jinglebells2020/netrodrone/cad/out/step/netrodrone_assembly.step

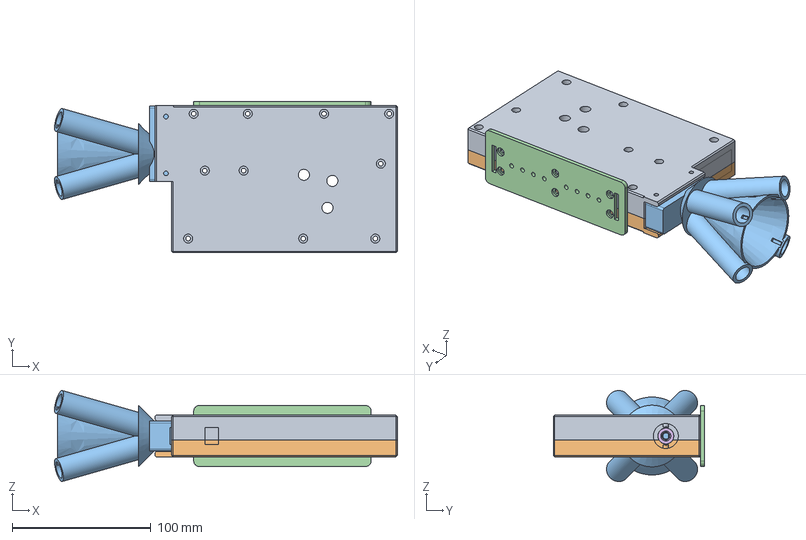
[picture p15: CAD file, 2026-10-27]
cad/out/step/netrodrone_assembly.step
247.4 x 109.2 x 65.7 mm
