jinglebells2020/netrodrone/cad/out/step/nozzle_seal_sleeve_S8.step

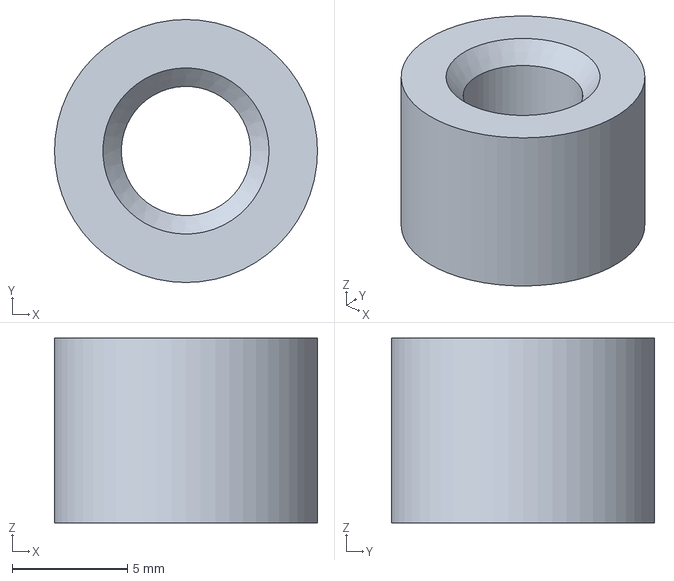
[picture p16: CAD file, 2026-10-27]
cad/out/step/nozzle_seal_sleeve_S8.step
11.4 x 11.4 x 8.00 mm
