jinglebells2020/netrodrone/cad/out/stl/net_weight_x4.stl

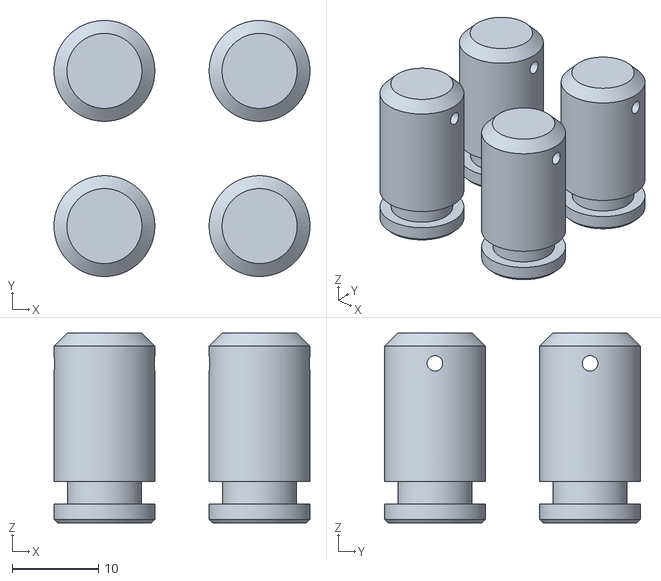
[picture p17: CAD file, 2026-10-27]
cad/out/stl/net_weight_x4.stl
29.7 x 29.7 x 22.0
