jinglebells2020/netrodrone/cad/source/gearbox_v2_original.step

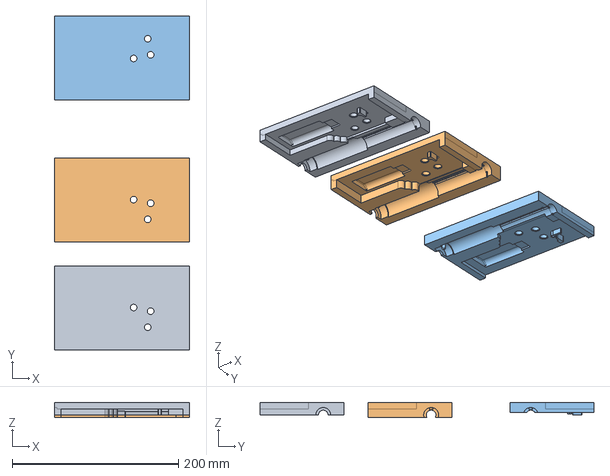
[picture p18: CAD file, 2026-10-27]
cad/source/gearbox_v2_original.step
163.0 x 402.4 x 18.0 mm
