jinglebells2020/netrodrone/cad/out/step/nozzle_seal_sleeve_S11.step

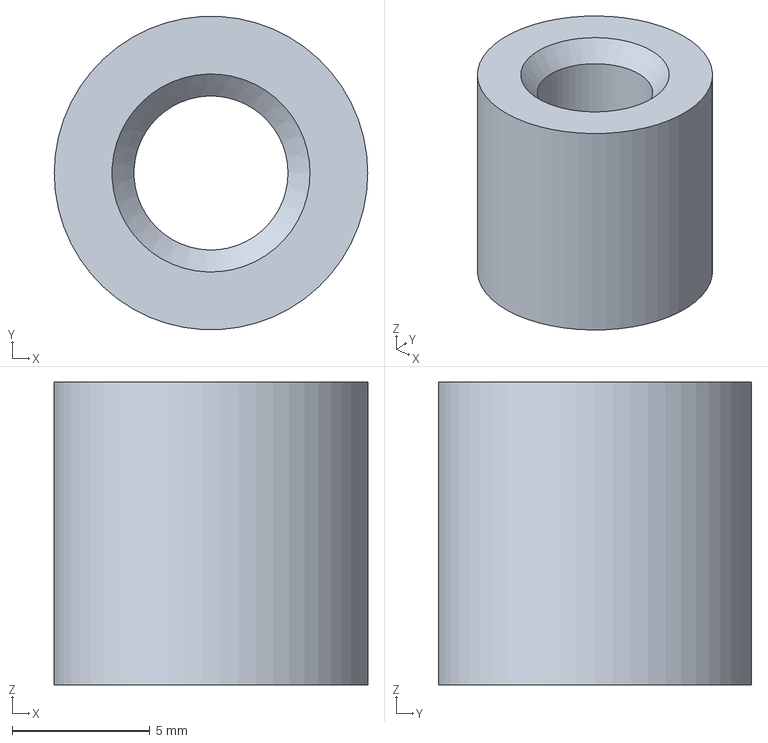
[picture p19: CAD file, 2026-10-27]
cad/out/step/nozzle_seal_sleeve_S11.step
11.4 x 11.4 x 11.0 mm
