jinglebells2020/netrodrone/cad/out/stl/nozzle_seal_sleeve_S14_TPU.stl

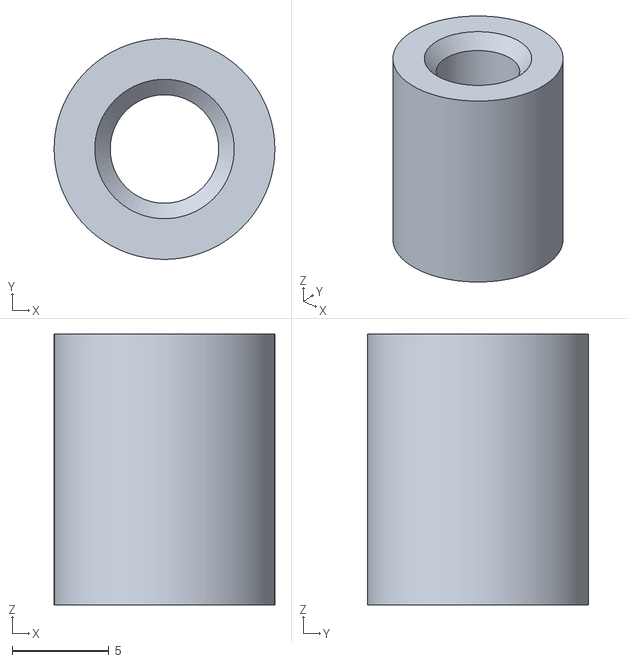
[picture p20: CAD file, 2026-10-27]
cad/out/stl/nozzle_seal_sleeve_S14_TPU.stl
11.4 x 11.4 x 14.0
