jinglebells2020/netrodrone/cad/out/step/nozzle_seal_sleeve_S17.step

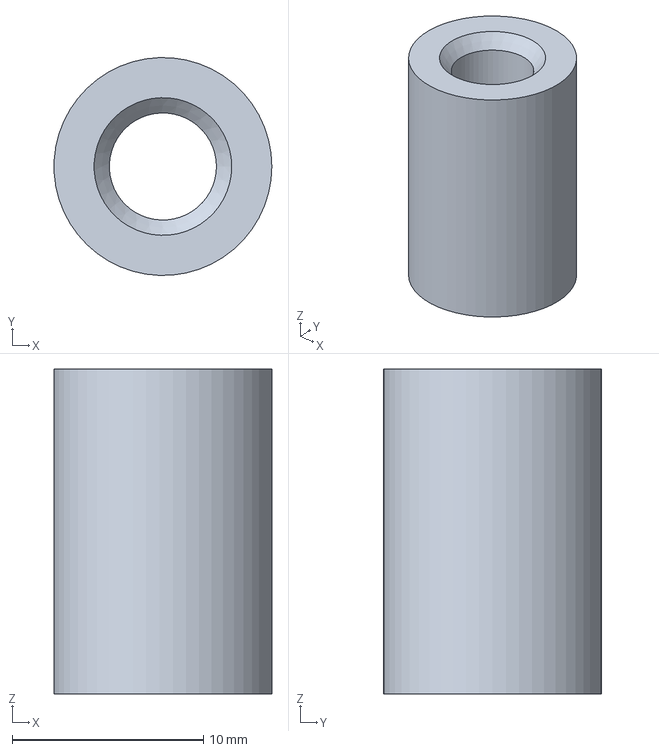
[picture p21: CAD file, 2026-10-27]
cad/out/step/nozzle_seal_sleeve_S17.step
11.4 x 11.4 x 17.0 mm
