jinglebells2020/netrodrone/cad/out/stl/nozzle_seal_sleeve_S5_TPU.stl

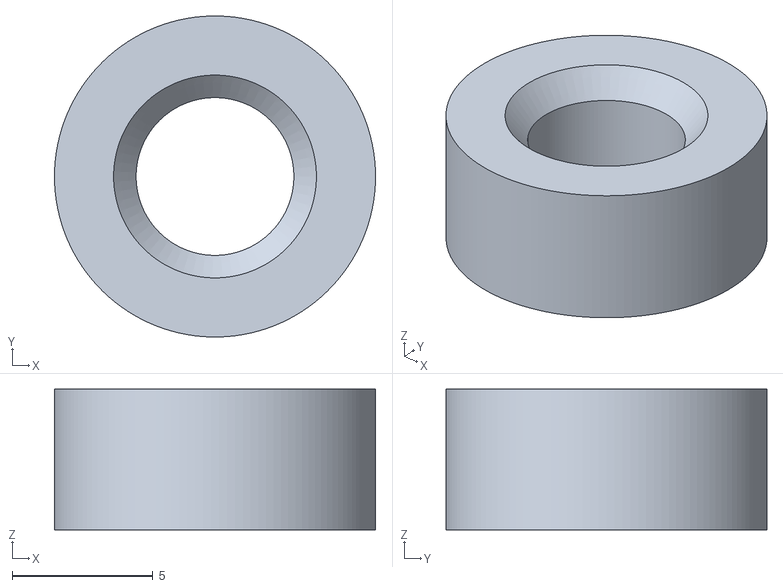
[picture p22: CAD file, 2026-10-27]
cad/out/stl/nozzle_seal_sleeve_S5_TPU.stl
11.4 x 11.4 x 5.00
