jinglebells2020/netrodrone/cad/out/step/gearbox_half_B.step

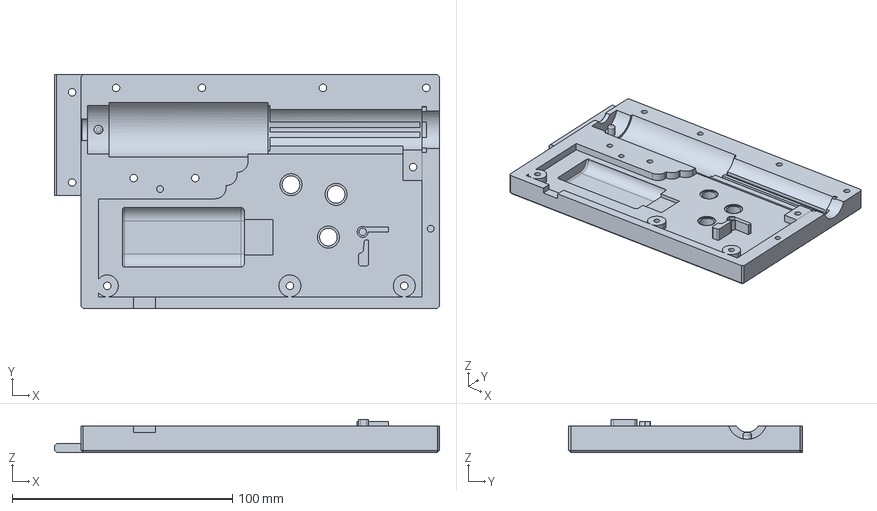
[picture p23: CAD file, 2026-10-27]
cad/out/step/gearbox_half_B.step
175.0 x 106.2 x 15.0 mm
