jinglebells2020/netrodrone/cad/out/step/mount_plate.step

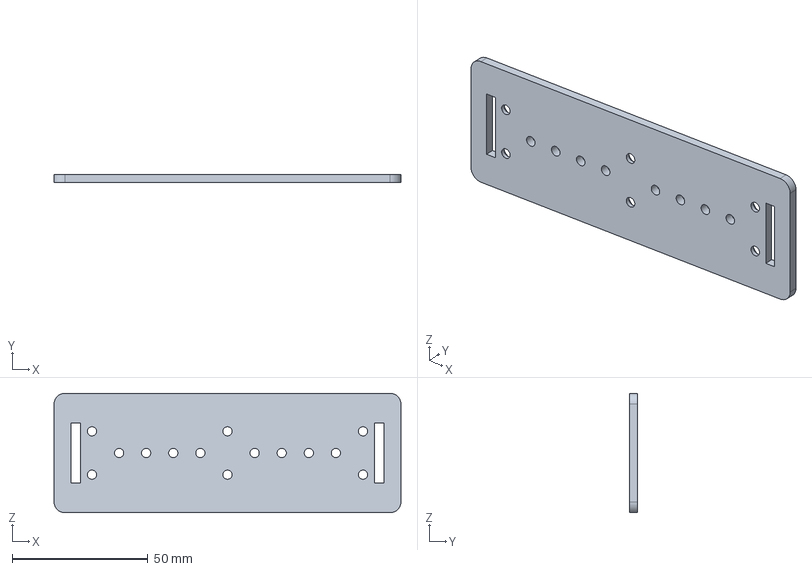
[picture p24: CAD file, 2026-10-27]
cad/out/step/mount_plate.step
128.0 x 3.00 x 44.0 mm
