jinglebells2020/netrodrone/cad/out/step/net_weight.step

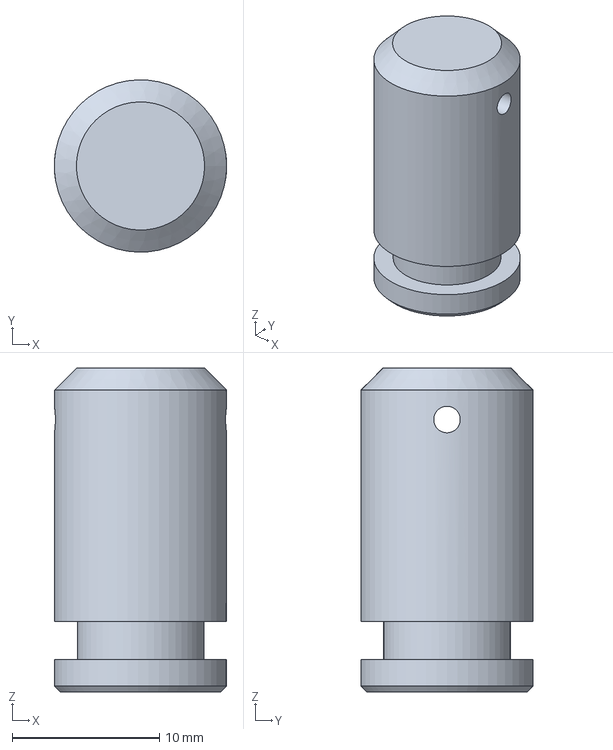
[picture p25: CAD file, 2026-10-27]
cad/out/step/net_weight.step
11.7 x 11.7 x 22.0 mm
