jinglebells2020/netrodrone/cad/out/step/gearbox_half_A.step

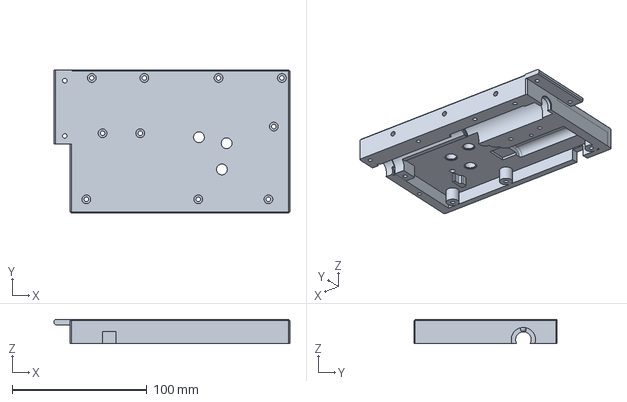
[picture p26: CAD file, 2026-10-27]
cad/out/step/gearbox_half_A.step
175.0 x 106.2 x 18.0 mm
