jinglebells2020/netrodrone/cad/out/step/launcher_head.step

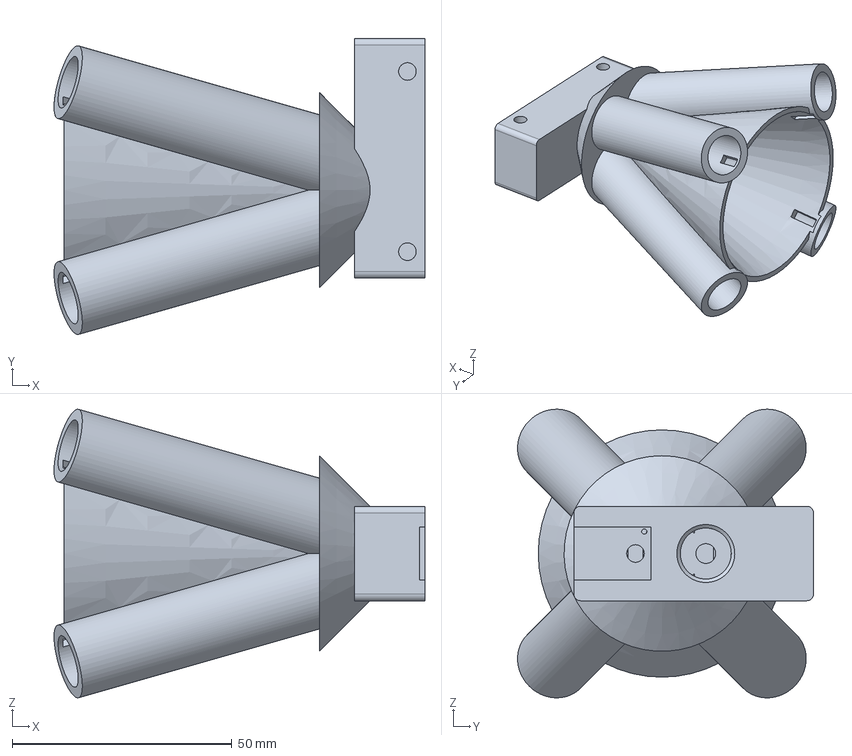
[picture p27: CAD file, 2026-10-27]
cad/out/step/launcher_head.step
84.4 x 67.3 x 65.7 mm
