jinglebells2020/netrodrone/(list of files, cad)

Other CAD files:
cad/out/stl/nozzle_seal_sleeve_S11_TPU.stl
cad/out/stl/nozzle_seal_sleeve_S17_TPU.stl
cad/out/step/nozzle_seal_sleeve_S14.step
cad/out/stl/nozzle_seal_sleeve_S8_TPU.stl
cad/out/step/nozzle_seal_sleeve_S5.step
cad/out/stl/gearbox_half_A.stl
cad/out/stl/gearbox_half_B.stl
cad/out/stl/launcher_head.stl
cad/out/stl/mount_plate.stl
