jinglebells2020/netrodrone/analysis/RESULTS.md

# Simulation results

Generated by `analysis/run_analysis.py`. Design point: 4 barrels, bore 12 mm, 42 mm weight travel, stock AEG nozzle (4 mm bore), O-ring sealed weights, 22° spread, 1.2 m net.

## Spring calibration (from the AEG rating: M120 = ~120 m/s with a 0.20 g BB)

| spring | model | rate k (N/mm) | force cocked (N) | stored energy (J) |
|---|---|---|---|---|
| M100 | conservative | 0.43 | 46 | 1.79 |
| M100 | expected | 0.67 | 71 | 2.81 |
| M120 | conservative | 0.55 | 59 | 2.31 |
| M120 | expected | 0.82 | 88 | 3.45 |
| M150 | conservative | 0.77 | 82 | 3.24 |
| M150 | expected | 1.10 | 118 | 4.63 |

## Weight speed leaving the barrels (m/s), conservative - expected

| spring | 6 g | 8 g (design) | 10 g | 12 g | energy to weights @ 8 g (J) | peak pressure @ 8 g (bar) |
|---|---|---|---|---|---|---|
| M100 | 8.5 - 9.6 | 7.5 - 8.5 | 6.7 - 7.6 | 6.0 - 6.8 | 0.90 - 1.15 | 1.7 - 2.1 |
| M120 | 10.5 - 11.3 | 9.3 - 10.0 | 8.3 - 8.9 | 7.5 - 8.1 | 1.38 - 1.60 | 2.4 - 2.9 |
| M150 | 13.1 - 13.4 | 11.6 - 11.9 | 10.5 - 10.8 | 9.4 - 9.9 | 2.17 - 2.28 | 4.2 - 4.8 |

Shot duration (release to weights out): 10.9 ms (M120). Piston hits the cylinder head at <= 2.9 m/s (the air in front of it cushions the stop).

## Net flight (1.2 m net, 4 x 8 g, 22°)

| spring | model | weight speed (m/s) | 70 % open at | 90 % open at | capture window |
|---|---|---|---|---|---|
| M100 | conservative | 7.5 | 1.6 m | 2.2 m | 1.6 - 3.1 m |
| M100 | expected | 8.5 | 1.5 m | 2.1 m | 1.5 - 3.4 m |
| M120 | conservative | 9.3 | 1.5 m | 2.1 m | 1.5 - 3.6 m |
| M120 | expected | 10.0 | 1.5 m | 2.1 m | 1.5 - 3.8 m |
| M150 | conservative | 11.6 | 1.6 m | 2.1 m | 1.6 - 4.2 m |
| M150 | expected | 11.9 | 1.5 m | 2.1 m | 1.5 - 4.2 m |

## What breaks it, what doesn't (M120, 8 g weights)

| change from the design | weight speed (m/s) | change |
|---|---|---|
| design point (check valve + 1 mm bleed, O-rings, 4 mm nozzle) | 9.3 | +0 % |
| **no check valve** (system sealed between shots) | 0.0 | **weights do not leave the barrels** |
| no check valve, but a vented AEG piston head (~2 mm2) | 7.0 | -24 % |
| **no O-rings on the weights** (0.1 mm printed gap) | 0.0 | **weights do not leave the barrels** |
| worn / dry O-rings (1 mm2 leak each) | 7.7 | -18 % |
| high O-ring friction (3 N each) | 8.2 | -12 % |
| nozzle bore 3.5 mm | 8.7 | -6 % |
| nozzle bore 5.0 mm | 9.8 | +5 % |
| bleed hole 1.5 mm | 8.8 | -5 % |
| no bleed hole | 9.6 | +4 % |
| fast cocking (15 ms) | 9.5 | +2 % |
| slow cocking (40 ms) | 9.2 | -1 % |
| weight travel 36 mm | 9.4 | +1 % |
| weight travel 48 mm | 9.1 | -2 % |
| 4 x 14 mm bores, 100 mm travel (barrels too big) | 0.0 | **weights do not leave the barrels** |

## Spread angle (M120, conservative)

| half-angle | 90 % open at | capture window |
|---|---|---|
| 18° | 3.0 m | 2.0 - 4.0 m |
| 22° | 2.1 m | 1.5 - 3.6 m |
| 26° | 1.7 m | 1.2 - 3.2 m |
| 30° | 1.4 m | 0.9 - 2.9 m |
