jinglebells2020/netrodrone/analysis/turret/RESULTS.md

# Turret engagement simulation

Generated by `engage.py`. A drone dives 20° at a point on the building at 30 m/s (108 km/h) unless stated; it is first seen 60 m out, from a random direction, so the head may have to turn up to 180°. Each cell is the share of 1000 engagements that end in a catch. Light launcher (2 m net, 36 J) unless stated.

Baseline: camera + 0.5 m ranging, 30 measurements a second with 80 ms delay, head turning 180°/s, 40 ms from fire command to the net leaving, net thrown within 1.5° and 4 % of its nominal speed.

## How far from the turret can the drone be aimed?

| sensor | 0 m | 1 m | 2 m | 3 m | 4 m | 5 m |
|---|---|---|---|---|---|---|
| camera only (range guessed from image size) | 100 % | 98 % | 91 % | 74 % | 53 % | 30 % |
| camera + rangefinder or small radar (0.5 m) | 100 % | 99 % | 94 % | 88 % | 93 % | 88 % |
| camera + good radar (0.15 m) | 100 % | 100 % | 94 % | 96 % | 95 % | 94 % |

Column = how far the drone's aim point is from the turret. Beyond the net's reach nothing helps.

## Drone speed (aim point 1 m from the turret)

| sensor | 20 m/s | 30 m/s | 40 m/s |
|---|---|---|---|
| camera only (range guessed from image size) | 100 % | 97 % | 75 % |
| camera + rangefinder or small radar (0.5 m) | 100 % | 99 % | 84 % |
| camera + good radar (0.15 m) | 100 % | 100 % | 87 % |

## Head speed and how early the drone is seen (aim point 1 m away)

| head turns at | seen at 40 m | seen at 60 m | seen at 80 m |
|---|---|---|---|
| 60°/s | 26 % | 44 % | 63 % |
| 120°/s | 51 % | 88 % | 99 % |
| 180°/s | 71 % | 99 % | 100 % |
| 360°/s | 97 % | 100 % | 100 % |

## Measurement rate and delay

| sensor timing | aim point 1 m away | 3 m away |
|---|---|---|
| 15 pictures a second, 150 ms delay | 96 % | 83 % |
| 30 a second, 80 ms | 99 % | 89 % |
| 60 a second, 30 ms | 99 % | 84 % |

## A drone that does not fly straight (aim point 1 m away)

The drone weaves from side to side once a second; the column is the peak sideways acceleration. 'Far' and 'near' are where the fire control prefers to meet the drone within the net's reach.

| launcher, meeting point | straight | 0.25 g | 0.5 g | 1 g | 2 g |
|---|---|---|---|---|---|
| light, far (about 6 m out) | 99 % | 98 % | 95 % | 52 % | 0 % |
| light, near (about 2 m out) | 69 % | 60 % | 44 % | 10 % | 1 % |
| medium, far (about 8 m out) | 99 % | 100 % | 99 % | 90 % | 4 % |
| medium, near (about 3 m out) | 86 % | 79 % | 64 % | 21 % | 5 % |
| medium-wide, far (about 6 m out) | 99 % | 99 % | 98 % | 86 % | 7 % |
| medium-wide, near (about 2 m out) | 74 % | 67 % | 52 % | 35 % | 5 % |
| heavy, far (about 14 m out) | 100 % | 100 % | 99 % | 96 % | 38 % |
| heavy, near (about 6 m out) | 100 % | 100 % | 97 % | 70 % | 5 % |
| heavy-wide, far (about 9 m out) | 100 % | 100 % | 99 % | 99 % | 80 % |
| heavy-wide, near (about 3 m out) | 88 % | 83 % | 70 % | 44 % | 11 % |

## How far from the turret can the drone be aimed, by launcher

| light: aim point from the turret | 0 m | 1 m | 2 m | 3 m | 4 m | 5 m | 6 m |
|---|---|---|---|---|---|---|---|
| catch | 100 % | 99 % | 95 % | 86 % | 92 % | 86 % | 1 % |

| medium: aim point from the turret | 0 m | 2 m | 4 m | 6 m | 8 m | 10 m |
|---|---|---|---|---|---|---|
| catch | 100 % | 98 % | 97 % | 98 % | 55 % | 0 % |

| medium-wide: aim point from the turret | 0 m | 2 m | 4 m | 6 m | 8 m |
|---|---|---|---|---|---|
| catch | 100 % | 97 % | 82 % | 68 % | 0 % |

| heavy: aim point from the turret | 0 m | 4 m | 8 m | 12 m | 16 m |
|---|---|---|---|---|---|
| catch | 100 % | 96 % | 90 % | 72 % | 0 % |

| heavy-wide: aim point from the turret | 0 m | 2 m | 4 m | 6 m | 8 m | 10 m |
|---|---|---|---|---|---|---|
| catch | 100 % | 99 % | 99 % | 91 % | 95 % | 0 % |

## What else could go wrong (aim point 1 m away)

| change | catch | typical sideways miss |
|---|---|---|
| baseline | 100 % | 0.21 m |
| net thrown 4 deg off instead of 1.5 | 88 % | 0.47 m |
| net speed varies 10 % instead of 4 % | 99 % | 0.21 m |
| valve takes 100 ms instead of 40 ms (known) | 99 % | 0.23 m |

## Tracking head v0: two fixed cameras as a stereo pair, hobby bus servos

Two identical cameras 0.4 m apart at 1280 x 720 give range from the difference between the two pictures; the error grows with distance squared (about 2.3 m at 60 m, 0.6 m at 30 m, 0.14 m at 15 m). Drone seen at 45 m, head turning 250°/s, 30 measurements a second with 50 ms delay, light launcher.

| aim point from the turret | 0 m | 1 m | 2 m | 3 m | 4 m | 5 m |
|---|---|---|---|---|---|---|
| catch (30 m/s, straight) | 100 % | 98 % | 96 % | 97 % | 95 % | 85 % |

| aim point 1 m away | 20 m/s | 30 m/s | 40 m/s | weaving 0.5 g | 1 g |
|---|---|---|---|---|---|
| catch | 100 % | 99 % | 78 % | 95 % | 51 % |

## Why engagements fail (baseline sensor)

| aim point from the turret | caught | fired and missed | head not ready | never in reach |
|---|---|---|---|---|
| 0 m | 100 % | 0 % | 0 % | 0 % |
| 1 m | 99 % | 0 % | 0 % | 0 % |
| 2 m | 94 % | 3 % | 0 % | 3 % |
| 3 m | 88 % | 11 % | 0 % | 1 % |
| 4 m | 93 % | 7 % | 0 % | 0 % |
| 5 m | 88 % | 12 % | 0 % | 0 % |

Not modelled: evasion other than a steady weave, several drones at once, rain or darkness on the camera, and what the netted drone does afterwards (it keeps most of its speed; see the discussion of catch distance).
