jinglebells2020/netrodrone/(commit log)

2026-10-27 Add V2-gearbox net launcher: improved gearbox halves, launcher head, physics checks
    Gearbox (built from the user's "GearBox V2 lower" STEP, bodies BLOCK (1) and
    BLOCK (1) (1)): every component fit is kept; changes are boolean adds/cuts only.
    - close the open gear-pocket bottom (5 mm wall + motor-wire slot)
    - 10 x M3 through-bolts (counterbores / nut traps), 3 pocket bosses, 2 dowels
    - forward tabs that hold the launcher head, 6 M3 insert holes for a drone mount
    - 1 mm outer chamfers
    Net launcher (new parts): 4-barrel head (12 mm bores, 22 deg spread, net cup),
    BB check valve + bleed so the sealed launcher refills while cocking, O-ring
    sealed 8 g net weights, TPU nozzle seal sleeves (5 lengt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
    [gearbox_half_A.step, gearbox_half_A.stl, gearbox_half_B.step, gearbox_half_B.stl, gearbox_v2_original.step, launcher_head.step, launcher_head.stl, mount_plate.step]
2026-10-27 Add tactics studies, method comparison and research notes
    - analysis/tactics/: firing modes vs airspeed, down-strike drift, the drape
    tactic (original and fixed), 150 km/h targets, and a fast numba capture
    model (capture.py, validated against drape.py and netflight.py) used to
    compare every method head-to-head over target speed and aiming error
    (6,704 runs in out/compare_methods.csv, tables in RESULTS.md)
    - docs/RESEARCH.md: findings with sources (what pushes what, detection and
    the from-above tactic, latex bands, drape, fast targets, attack-drone
    speeds, market size)
    - docs/figures/: scripts and three.js renderer for the CAD pictures
    - docs/images/: what_flies_out, drape_tactic,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
    [compare_methods.csv]
2026-11-10 Add roof-turret study: launcher sizing, fire control and engagement simulation
    Start of the roof turret: a fixed net launcher on a building that tracks an
    incoming drone and throws a net into its path.
    - analysis/turret/classes.py: launcher sizes compared (2 m to 5 m nets, 36-720 J)
    - analysis/turret/envelope.py: net flight tables from the capture model
    (out/net_<class>.json committed)
    - analysis/turret/pneumatic.py: compressed air needed per shot
    - turret/firecontrol.py: tracker, pan-tilt model, choice of meeting point and
    firing time, shot scoring (no hardware in it)
    - analysis/turret/engage.py: 1,000 engagements per case -> RESULTS.md
    - analysis/turret/check_oblique.py: scoring rule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
2026-11-10 Engagement study: add the tracking head v0 case
    Two fixed cameras as a stereo pair (range error growing with distance squared)
    and hobby bus servos, to check that parts on hand are good enough for a first
    tracking head. Earlier tables are unchanged.
    Claude-Session: https://claude.ai/code/session_01Vz4ZGZrkmvxqF4L5WwBkMQ
2026-11-10 Compare launcher ideas: more weights, spiral launch, pushed-out net
    netlab.py generalises the net model to any number of weights, a net cut to a
    polygon with an edge rope, a sideways launch angle and a net bundle that is
    pushed out of the cup. It reproduces capture.py for the four-weight shot.
    launch_variants.py compares the ideas at equal energy and net area, with the
    catch half-width taken in the worst of three directions -> VARIANTS.md.
    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
2026-11-10 Compressed-air sizing: add valve opening time
    A valve that opens in 5 ms or less costs nothing; 20 ms costs 30-40 % of the
    shot energy, 40 ms more than half.
    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
